SamuelNoesslboeck/SyArm_Mk1/README.md

[SyArm Mk1.pdf](https://github.com/SamuelNoesslboeck/SyArm_Mk1/files/11110466/SyArm.Mk1.pdf)
