SamuelNoesslboeck/SyArm_Mk1/documentation/articles/SyArm_Mechanics.pdf

# SyArm Mechanics

Samuel N¨osslb¨ock

April 2022

## 1 Introduction

This article is all about the mechanics of the SyArm. It is important to know which forces the load applies on which parts of the robot.

## 2 Servo replacement

As servo motors do not have enough torque to withstand the forces created by the load and the arms own weight, they have to be replaced by electronic cylinders. But as cylinders can only extend and descend they need to be build in between the joints, which requires additional vector mathematics to convert the angle previously needed for the servo motors into an extension for the cylinders.


The schematic above shows the second cylinder C2, which is responsible for the angle in joint A2. However the following equations can be applied to every cylinder when using the corresponding lengths instead of the ones used in this overall definition.
As many of the vectors are representing the construction their length is therefore known and can be used as constants:
| ⃗a1| = const | ⃗a2| = const | 1⃗a M| = const | 2⃗a M| = const | 1⃗a MC | = const | 1⃗a MC | = const | (1)

The control script now gets a position and calculates the angle α. When knowing this angle, the script can calculate the length of the cylinder C2 needed to match the angle.

h =

q
|⃗a1 − ⃗a1M|

2 + 1⃗a MC

2
g =

q
|⃗a2 − ⃗a2M|

2 + 2⃗a MC

2
(2)

β = α − arcsin
| 2⃗a MC |
g

− arcsin
| 1⃗a MC |
h
(3)

Applying the law of cosines, C2 can be calculated with

C2

2 = g
2 + h
2 − 2gh cos(β) | (4)

When knowing the minimum and maximum length of the cylinder Cmin and Cmax, the minimum and maximum angle of β can be calculated using

βmin/max = arccos

a

2 + b

2 − Cmin/max

2

2ab | !
(5)

1

5 CYLINDER FORCES | 2

## 3 Angular speed of cylinders

The cylinders used to replace the servo motors have a given extension speed vC which means their total cylinder length results in the integral of this constant.

C(t) = Z
vC dt = vC t + C0 | (6)

When using the formula for section two for the inner angle β and inserting the equation above for the dependency in cylinder length, the formula now gets a dependency of time.

β(C(t)) = arccos
a

2 + b

2 − C(t)

2
2ab |

−→ β(t) = arccos
a

2 + b

2 − v

2
C t

2 − 2vC tC0 − C

2
0
2ab |
(7)

Now that β has its dependency over time, the angular speed can be calculated using the derivative of the equation above.

ω(t) = dβ
dt =

2C(t)
p
−C(t)

4 − g

4 − h

4 + 2c

2 + g

2 + h

2 + 2g

2h

2

(8)

## 4 Optimizing angle span

As the SyArm should be able to reach as much space as easy as possible, the concept of the angle span is important.

βspan = βmax − βmin | (9)

## 5 Cylinder forces

To clarify the calculation of all forces and loads acting on the arm, each part is treated separately. However a few formulas can be generally defined, as they are true for all cylinder cases.
The following equations are all based on the fundamental principal of statics

XM⃗
n = 0 | XF⃗
n = 0 | (10)

The force acting on every cylinder balances the torque in the given arm section

F⃗Cn =

PM⃗ An−1|
|C⃗
n × ⃗an|
- C⃗
n | (11)

and the force acting on the joint in this section balances all acting forces

F ⃗An−1 = −

XF⃗
n | (12)

First Section


5 CYLINDER FORCES | 3
mL = const mG3 = const | ⃗a3| = const | (13)

F⃗L =

0
0
mLg
- F⃗G3 =

0
0
mG3g
- ⃗aC3 = ⃗a3M + ⃗a3MC | (14)

F⃗C3 =

|F⃗L × ⃗a3 + F⃗G3 × ⃗aG3|
|C⃗
3 × ⃗aC3|
- C⃗
3 | F⃗A2 = −(F⃗L + +⃗ FG3 − F⃗C3) | (15)

Second Section


mL = const mG3 = const | ⃗a3| = const | (16)
