SamuelNoesslboeck/SyArm_Mk1/documentation/articles/Stepper_Motor.pdf

# Stepper Motors: Acceleration and torque curves

Samuel N¨osslb¨ock

October 2022

## 1 Introduction

This article is all about the optimization for stepper motors, the perfect way to start/stop them, and the maximum loads at certain speeds.

## 2 Motor torque and ”Coil pendulum”

Taking a stepper motor with two different coils A and B with the charging curve being defined as

ic(t) = Im(1 − e

t
τ ) τ =

ImL
U

(1)

IM being the maximum current flowing though the coil, L being the inductivity and U being the volage applied to the coil. Considering the torque has a linear proportionality to the current flowing though the coil:

T(t) ↔ i(t)

the following equations are valid for current and torque.
As the coils get charged and discharged, a kind of pendulum forms with a peak saturation voltage isat(t)

isat(t) = (isat(t) + Im)(1 − e

− t
τ ) − isat(t)

isat(t)(1 + e

− t
τ ) = Im(1 − e

− t
τ )

isat(t) = Im

1 − e

− t
τ
1 + e

− t
τ

⇒ T(t) = TS

1 − e

− t
τ
1 + e

− t
τ

(2)

Which, when used for calculating the torque, results in

limω→0

T(ω) = TS

1 − e

− t
τ
1 + e

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
The limit makes the function defined for an ω of 0, as is approches TS. TS represents the motors stall torque, ω the current rotational speed in radiants, nM the number of charging turns per turn (e.g. 200 step motor with 2 coils has 100 rechargings per turn) IM represents the maximum current for the coils, L the inductivity of the coils and U the voltage applied on the coils.

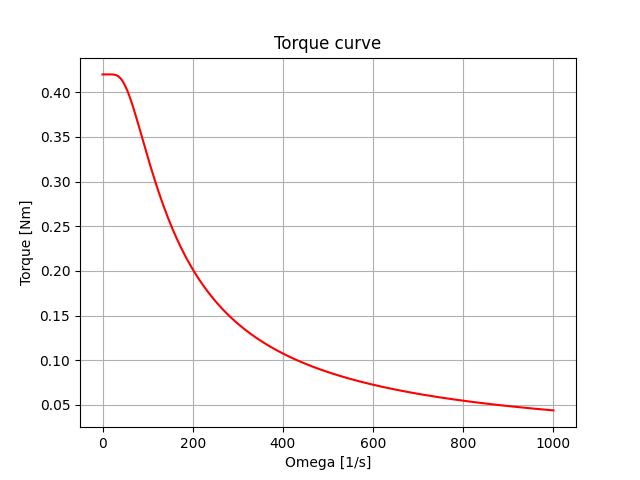
[picture p21: figure]

1

4 ACCELERATION CURVE | 2

## 3 Start and Stop speed

The starting point of an acceleration curve is the first step starting from standstill. If the motor cannot reach the first step before the controller recharges the coils, the motor will end up not working at all. As mentioned, the acceleration of the motor is the main parameter if it comes to start/stop speed. It is defined as following

α(t) = αm(1 − e

− t
τ ) αm =

TS − TL
J
TL < TS | (4)

With J being the inertia moment of the whole construction connected to the motor, TL being the torque loss and αM the maximum angluar velocity. Using the basic relationships over the integral

ω(t) = Z

α(t) dt ϕ(t) = Z
ω(t) dt

ϕ(t) = αm(

t

2
2

− τ

2
e

− t
τ ) | (5)
Especially for small motors at high voltages, the second term in the brackets can be ignored, as τ | 2 approaches 0.
Now to get the minimum first step time, this distance has to equal the step distance of the motor

2π
nS

= αm

t

2
2

t =

r
4π
αmnS
| (6)

where nS is the step count of the motor.

## 4 Acceleration curve

When knowing the start/stop speed, the acceleration curve can be defined as a series:

t0 =

r
4π
αmnS

tn =

2π
nSω(tt)

tt =

nX⁻¹

i=0

ti | (7)

Example curve:

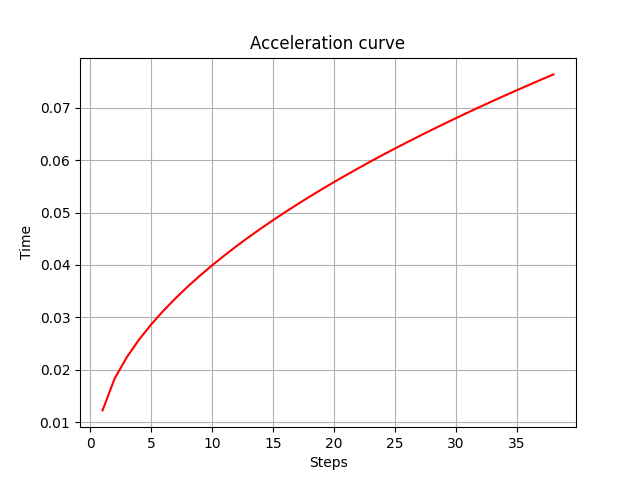
[picture p22: figure]
