SamuelNoesslboeck/SyArm_Mk1/documentation/articles/SyArm_Positioning.pdf

# SyArm Positioning

Samuel N¨osslb¨ock

April 2022

## 1 Introduction

The SyArm is build up from two arms and a tong, represented by three vectors.

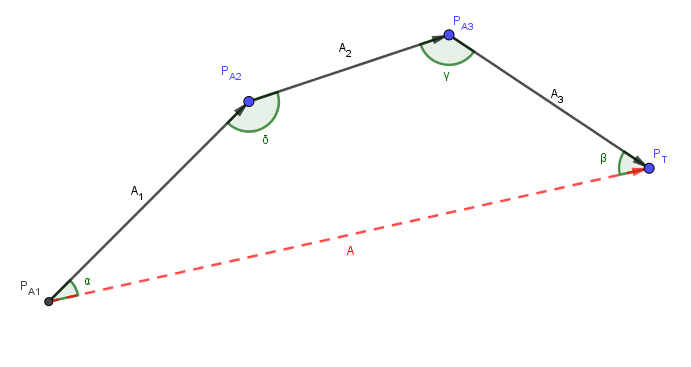
[picture p23: figure]

The robot is controlled by a Raspberry PI 3 with a simple systemd service which keeps the main python script alive.
The main positioning function just receives the three dimensional vector A⃗ and has to calculate all for the positioning relevant servo angles.
So the control script knows:
- All lengths A, A ⃗
10, A20, A30
- Another property δ = γ
An should calculate
- The servo angles ϕB, ϕA1, ϕA2, ϕT1
- The arm vectors A⃗

1, A⃗

2, A⃗
3

## 2 Base Angle ϕB

As the unmodified vectors all point along the Y-Axis, the base angle is the only angle that can move all arms towards the target and “create” a X-coordinate.

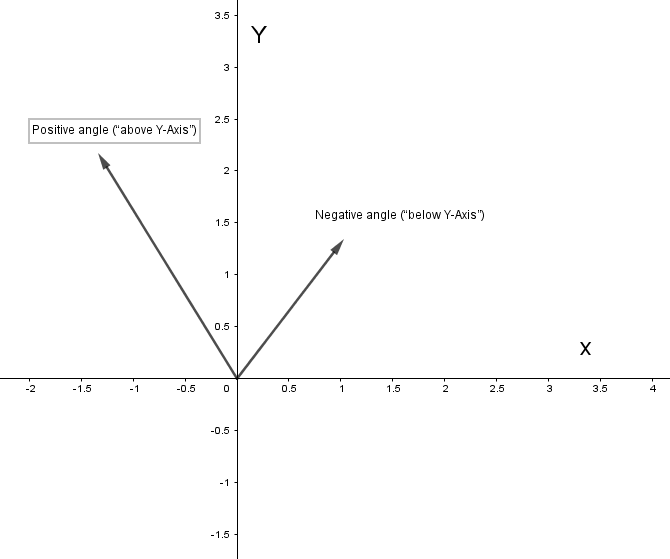
[picture p24: figure]

Because of this default Y-Axis, the system for a “positive” base angle is rotated by 90 degrees. Which means arcsin(y) cannot be applied here, the fully defined arc-function for this case is

ϕB(A⃗) =
arcsin(−xˆ) | if y >ˆ | 0
π + arcsin(−xˆ) otherwise | xˆ =

A⃗
q x
A⃗2
x + A⃗2
y

, yˆ =

A⃗
q y
A⃗2
x + A⃗2
y

(1)

## 3 Arm angles

To simplify the following equations simpler labels have been assigned to the following labels:
a = A, | b ⃗ | = A⃗
3, | c = A⃗
2, | d = A⃗
1
As we have all lengths of our polygon, we can extend the lengths b and d, to create a triangle.

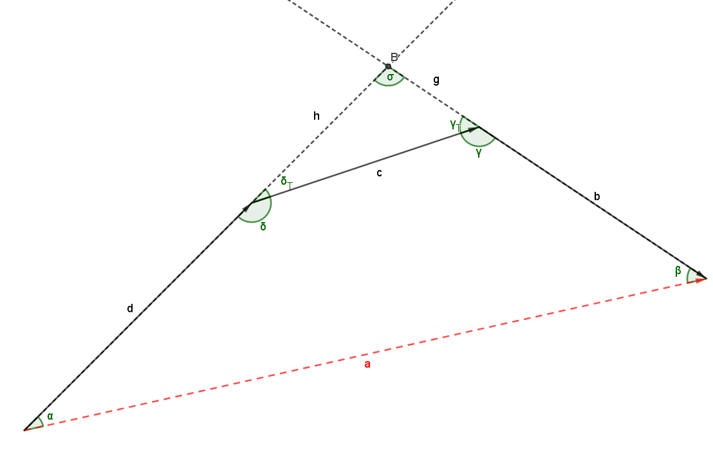
[picture p25: figure]

Considering the property δ = γ the following equations form

360 = α + β + γ + δx | (2)
180 = α + β + σ = δT + γT + σ | (3)
180 = δ + δT = γ + γT | (4)
δT = γT | g = h | (5)

As there are now two triangles, one of them being an isosceles one, the law of cosines can be applied

c

2 = h

2 + g

2 − 2gh cos(σ) = 2g

2
(1 − cos(σ)) | (6)

a

2 = (d + g)

2 + (b + g)

2 − 2(d + g)(b + g) cos(σ) | (7)

Out of equation (6), the cosine of sigma can be calculated with

cos(σ) = 1 −

| c
| 2
| 2g
| 2

(8)

When this result is inserted into equation (7) we can solve the unknown length g

a

2 = (d + g)

2 + (b + g)

2 − 2(d + g)(b + g)(1 −

c

2
2g

2 )
0 = d

2 + 2dg + g

2 + b

2 + 2bg + g

2 − 2db + | dbc² g
2 | − 2dg +

dc²
g − 2gb +

bc²
g − 2g

2 + c

2
0 = (−a

2 + b

2 + c

2 + d

2 − 2db) + 1
| g (dc² + bc²

) + 1
g

2 (dbc²
)
0 = g

2
(−a

2 + b

2 + c

2 + d

2 − 2db) + g(dc² + bc²

) + dbc²

(9)

For calculation, some helper variables are introduced

aC = −a

2 + b

2 + c

2 + d

2 − 2db
bC = dc² + bc²
cC = dbc²

(10)

g1,2 = −

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
(11)

When having the first result for g [g1], equation (8) can be used to calculate σ, γ and δ

σ = arccos(1 −

c

2
2g

2 )
γT =

180−σ
2
γ = δ = 180 − γT

(12)

When now having σ and the length of g, the law of sines can be applied

a
sin(σ)

=

d + h
sin(β)

=

b + g
sin(α)

(13)

So α and β result in
α = arcsin(sin(σ)(b + g)
a
) | (14)

β = arcsin(sin(σ)(d + h)
a
) | (15)

## 4 Arm vectors

The points of each joint and the final position vector can be calculated by using the default vectors

A⃗

10 = A⃗
1(ϕB = 0, ϕA1 = 0) =

0

A10
0
| (16)

A⃗

20 = A⃗
2(ϕB = 0, ϕA1 = 0, ϕA2 = 0) =

0

A20
0
- (17)

A⃗

30 = A⃗
3(ϕB = 0, ϕA1 = 0, ϕA2 = 0, ϕA3 = 0) =

0

A30
0
- (18)

and rotating around the servo axis using rotation matrices. The base rotation is represented by a Z-axis rotation, the joints by a X-axis rotation

A⃗

1(ϕB, ϕA1) = RZ(ϕB) · RX(ϕA1) · A⃗
10; PA1 =

0
0
0
- PA2(ϕB, ϕA1) = PA1 + A⃗
1(ϕB, ϕA1) | (19)

A⃗

2(ϕB, ϕA1, ϕA2) = RZ(ϕB) · RX(ϕA1) · RX(ϕA2) · A⃗

20 | PA3(ϕB, ϕA1, ϕA2) = PA2 + A⃗
2(ϕB, ϕA1, ϕA2) | (20)

A⃗

3(ϕB, ϕA1, ϕA2, ϕA3) = RZ(ϕB) · RX(ϕA1) · RX(ϕA2) · RX(ϕA3) · A⃗
30
PT1(ϕB, ϕA1, ϕA2, ϕA3) = PA3 + A⃗
3(ϕB, ϕA1, ϕA2, ϕA3)

(21)

Taking all of these vectors, the position vector A⃗ can be calculated

A⃗(ϕB, ϕA1, ϕA2, ϕA3) = A⃗

1(ϕB, ϕA1) + A⃗

2(ϕB, ϕA1, ϕA2) + A⃗
3(ϕB, ϕA1, ϕA2, ϕA3)
A⃗(ϕB, ϕA1, ϕA2, ϕA3) = RZ(ϕB) · RX(ϕA1) ·
A⃗
10 + RX(ϕA2) ·
A⃗

20 + RX(ϕA3) · A⃗

30 | (22)

## 5 Coordinate systems and conversions

The control script uses multiple coordinate systems listed here

Kath =

x
y
z
- Rot =

r
ϕZ
ϕX
- (23)

Kath and Rot both have their advantages and disadvantages, Rot is easier to use for the control system (it always converts to this system), while Kath is easier for human use. The conversion functions are the following

Kath(Rot) = RZ(ϕZ) · RX(ϕX) ·

0
r
0
- (24)

Rot(Kath) =

|Kath|
arctanF (y, −x)
arctanF (

p
x

2 + y

2, z)

- arctanF (x, y) =

arctan(y/x) | if x > 0
π + arctan(y/x) | if x < 0

π
2

if y > 0
−π
2

if y < 0
0 otherwise

otherwise

(25)
