SamuelNoesslboeck/SyArm_Mk1/documentation/images/actual/README.md

# Images of the actual robot

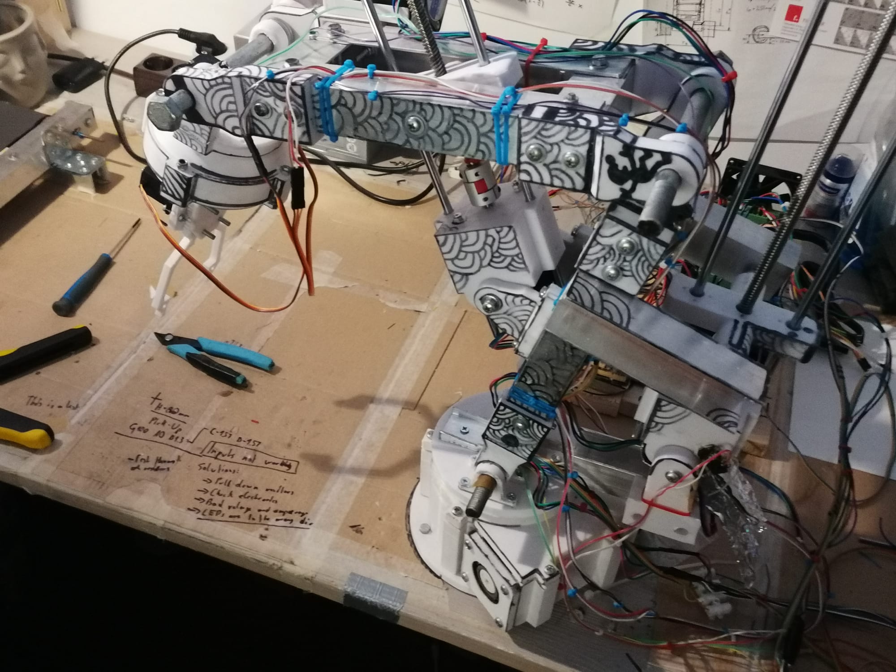
[picture p26: documentation/images/actual/Main_view.jpg]

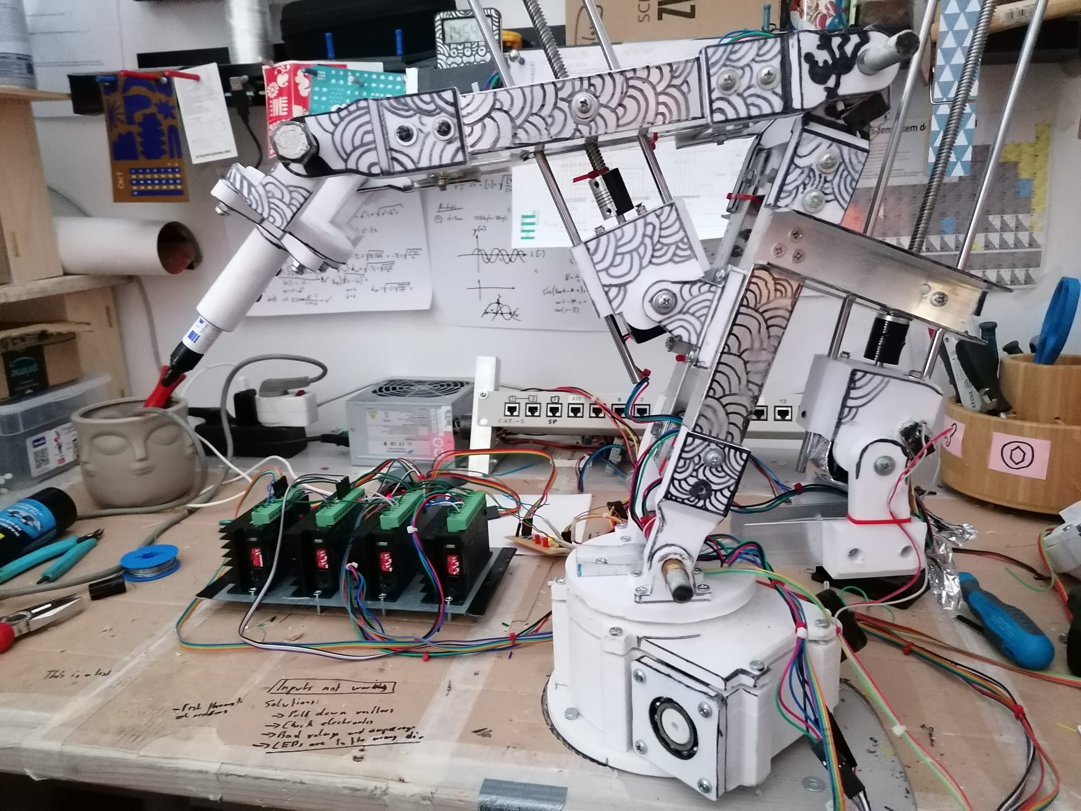
[picture p27: documentation/images/actual/Different_tools.jpg]

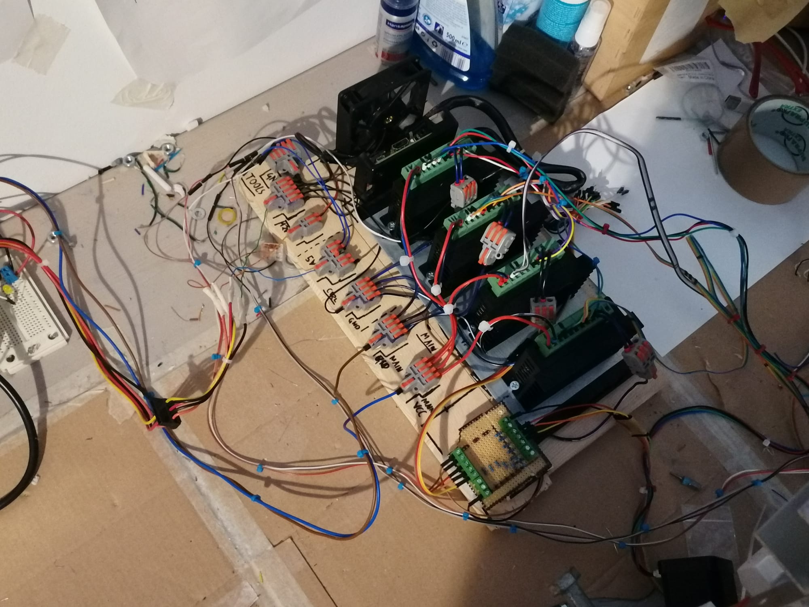
[picture p28: documentation/images/actual/Electronics.jpg]
