SamuelNoesslboeck/SyArm_Mk1/sketches/ArticleRaw.pdf

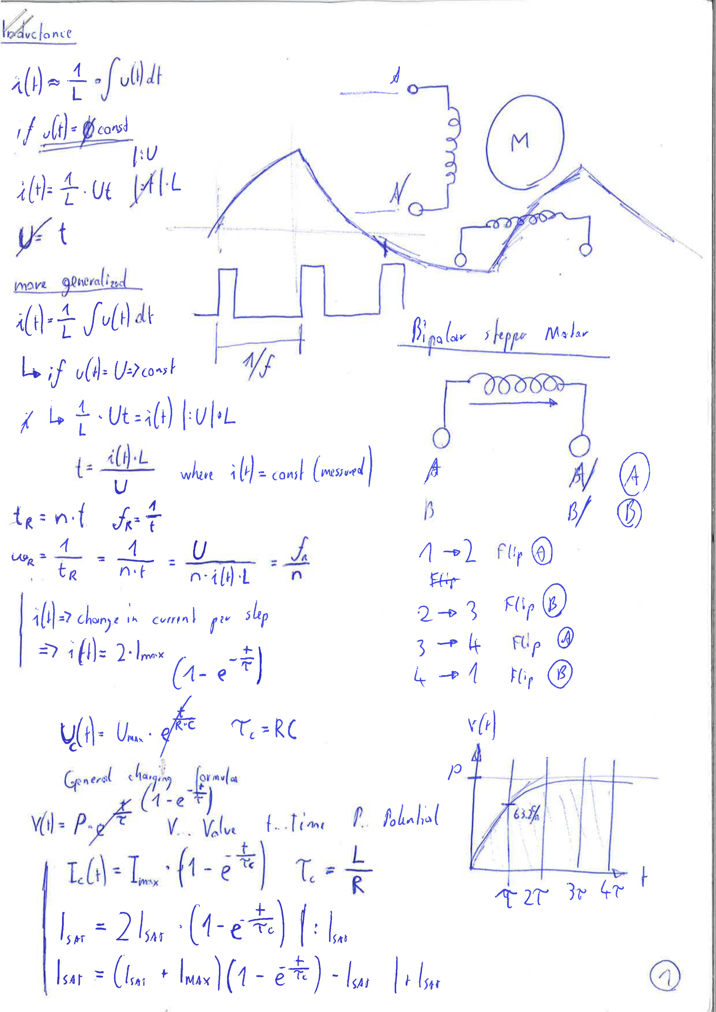
[picture p29: page 1]
