SamuelNoesslboeck/SyArm_Mk1/sketches/TimeFields.pdf

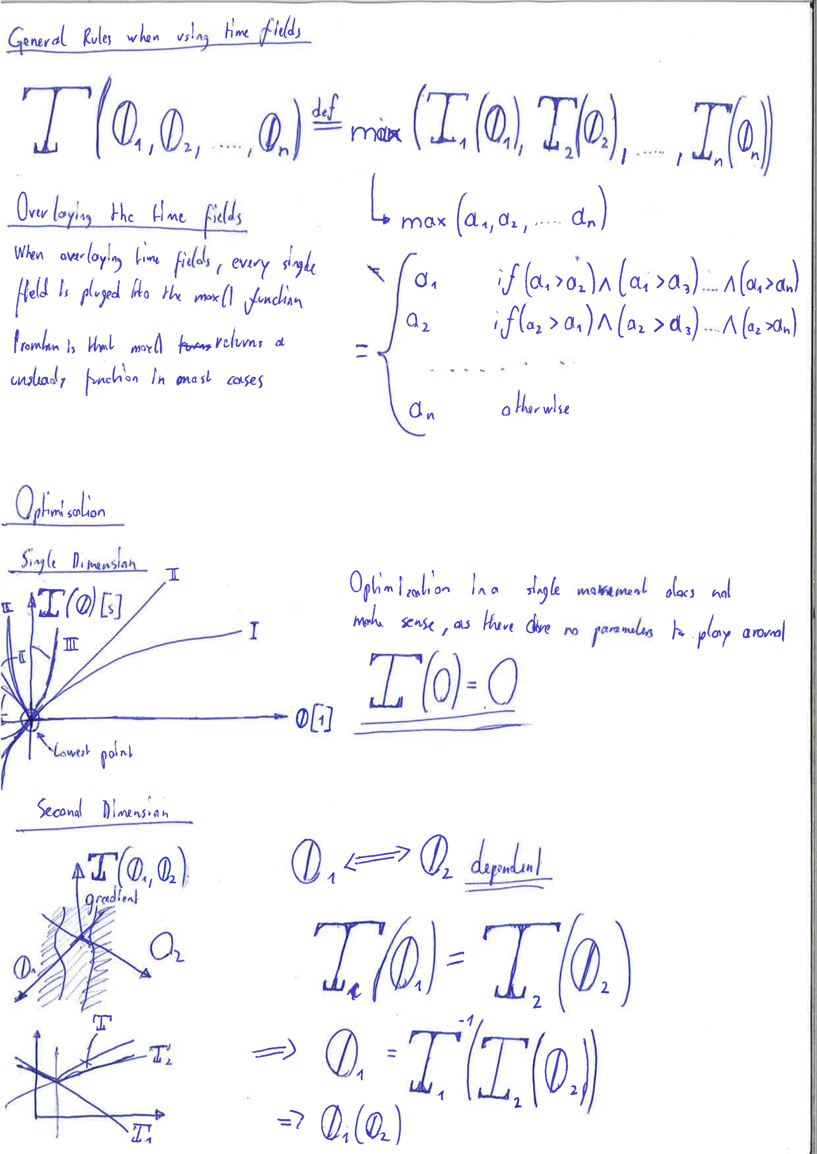
[picture p30: page 1]
