SamuelNoesslboeck/SyArm_Mk1/sketches/TimeFields_2.pdf

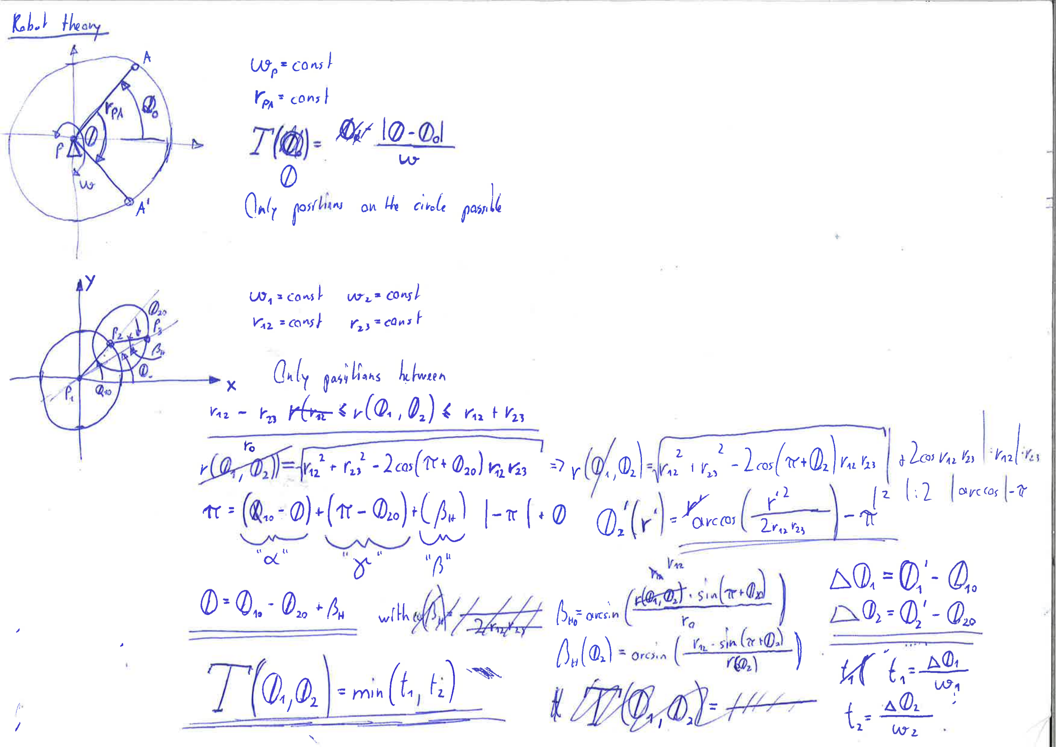
[picture p31: page 1]
