SamuelNoesslboeck/SyArm_Mk1/documentation/images/Base.png

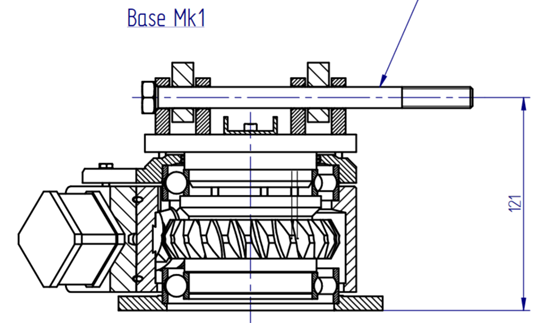
documentation/images/Base.png
