SamuelNoesslboeck/SyArm_Mk1/documentation/images/Cylinder.png

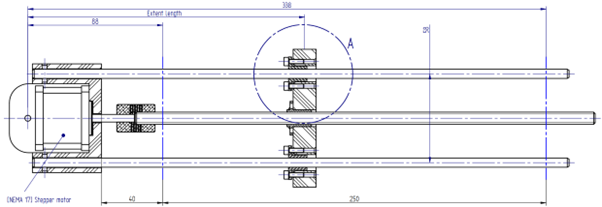
documentation/images/Cylinder.png
