SamuelNoesslboeck/SyArm_Mk1/documentation/images/CylinderTriangle.png

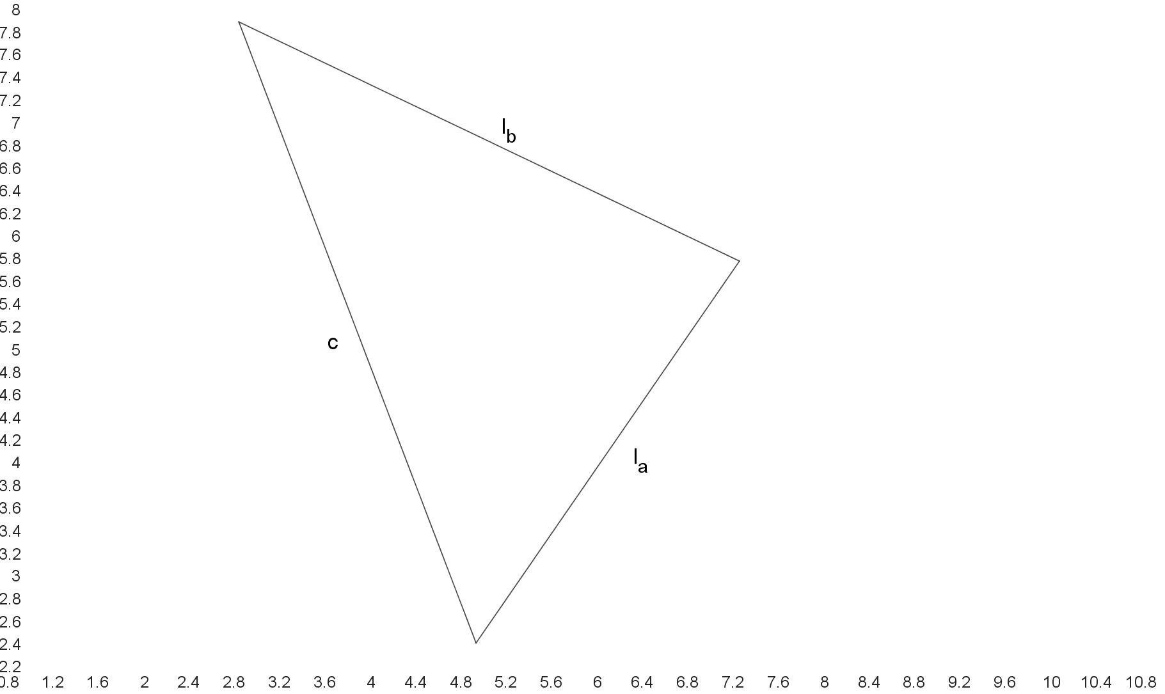
documentation/images/CylinderTriangle.png
