SamuelNoesslboeck/SyArm_Mk1/SyArm Mk1_files/image001.png

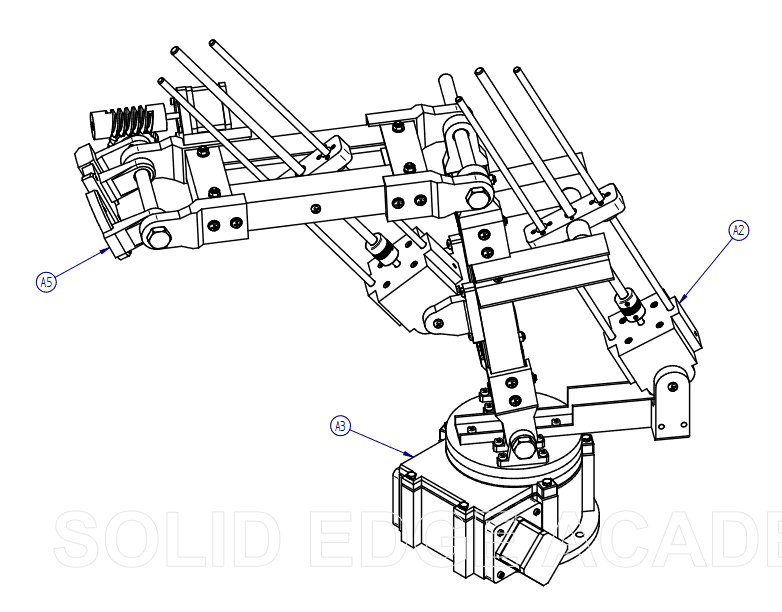
SyArm Mk1_files/image001.png
