SamuelNoesslboeck/SyArm_Mk1/SyArm Mk1_files/image007.png

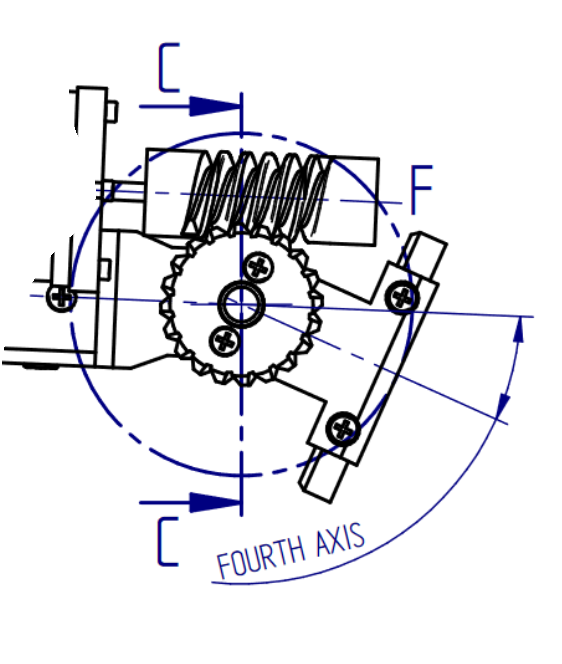
SyArm Mk1_files/image007.png
