SamuelNoesslboeck/SyArm_Mk1/SyArm Mk1_files/image019.png

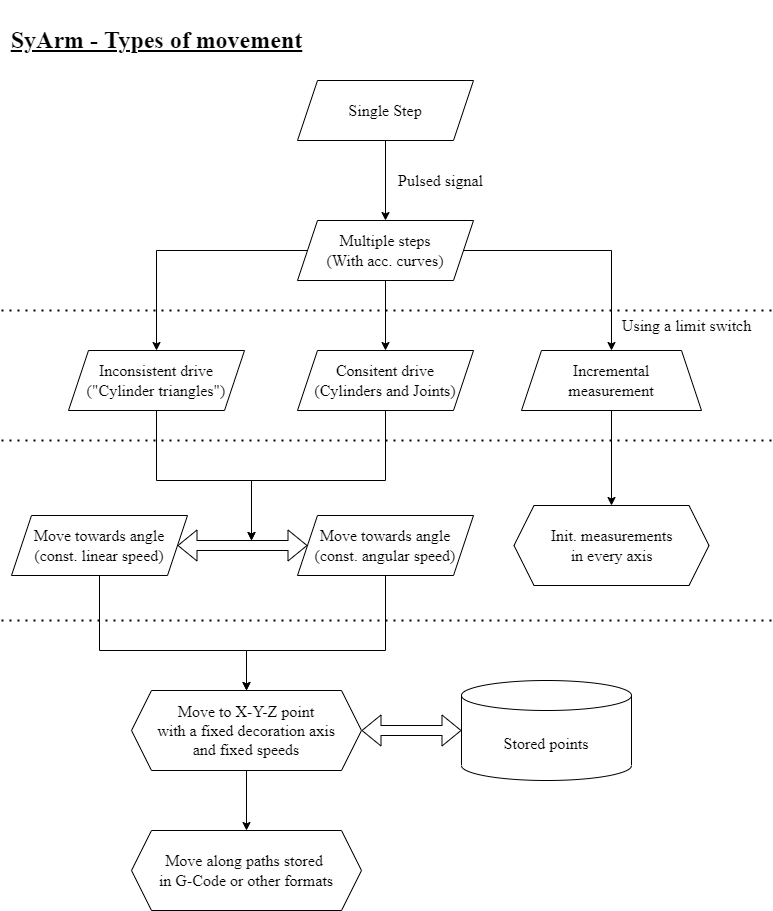
SyArm Mk1_files/image019.png
