SamuelNoesslboeck/SyArm_Mk1/construction/A4_Arm_Mk2/README.md

# Arm

Version: Mk2.4.0

## Construction

 - S1: First Segment 
 - S2: Second Segment
