SamuelNoesslboeck/SyArm_Mk1/construction/A1_SimpleFrame_Mk1/Drafts/SimpleFrame_Mk1.pdf

A

A

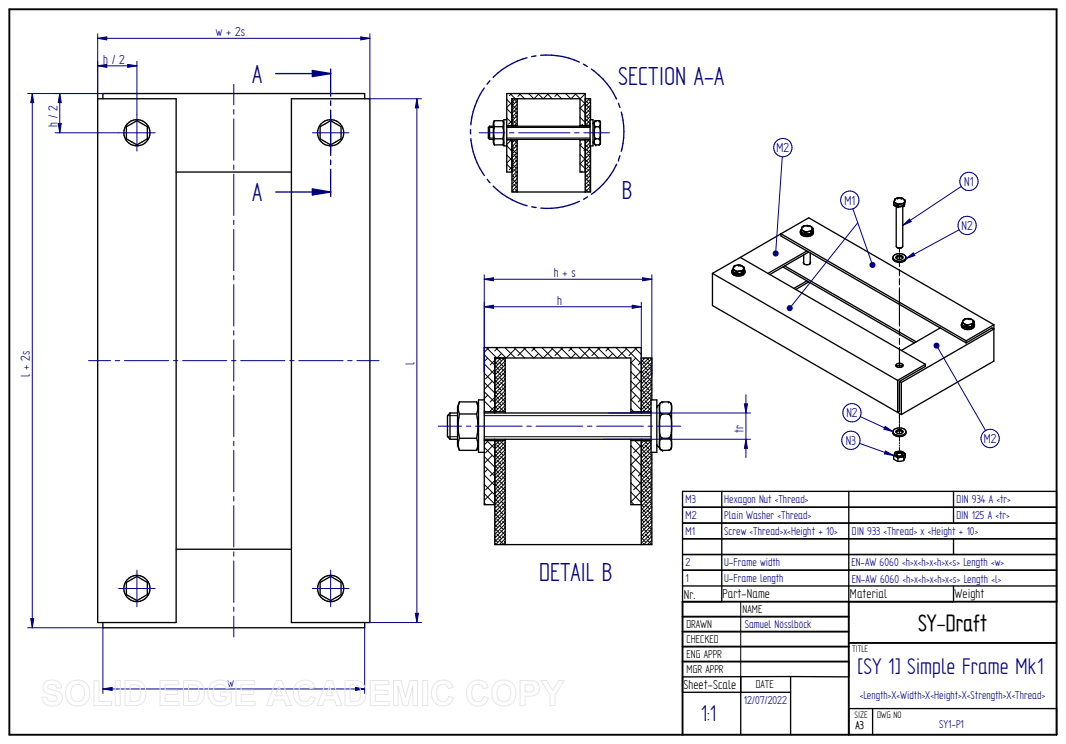
[picture p38: page 1]
SECTION A-A; DETAIL B

M3 | Hexagon Nut <Thread> | | DIN 934 A <tr>
M2 | Plain Washer <Thread> | | DIN 125 A <tr>
M1 | Screw <Thread>x<Height + 10> | DIN 933 <Thread> x <Height + 10>

2 | U-Frame width | EN-AW 6060 <h>x<h>x<h>x<s> Length <w>
1 | U-Frame length | EN-AW 6060 <h>x<h>x<h>x<s> Length <l>
Nr. | Part-Name | Material | Weight

NAME | SY-Draft

DRAWN | Samuel Nösslböck
CHECKED
ENG APPR
MGR APPR
Sheet-Scale | DATE
1:1 | 12/07/2022

TITLE
[SY 1] Simple Frame Mk1

<Length>X<Width>X<Height>X<Strength>X<Thread>

SIZE A3 | DWG NO SY1-P1
