SamuelNoesslboeck/SyArm_Mk1/construction/A2_Cylinder_Mk2/Drafts/A2_Cylinder_Mk2_2.pdf

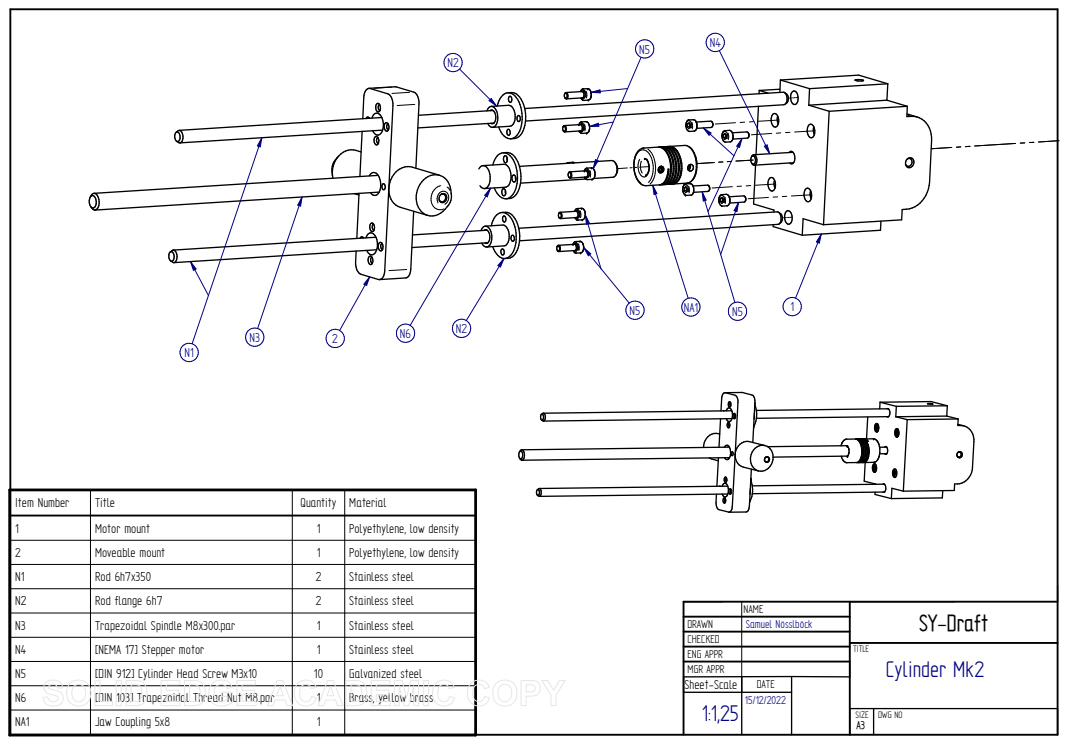
[picture p39: page 1]
MGR APPR; TITLE; Cylinder Mk2; SIZE A3; DWG NO; [DIN 912] Cylinder Head Screw M3x10; Galvanized steel; [DIN 103] Trapezoidal Thread Nut M8.par; Brass, yellow brass; Jaw Coupling 5x8

Item Number | Title | Quantity | Material
1 | Motor mount | 1 | Polyethylene, low density
2 | Moveable mount | 1 | Polyethylene, low density
N1 | Rod 6h7x350 | 2 | Stainless steel
N2 | Rod flange 6h7 | 2 | Stainless steel
N3 | Trapezoidal Spindle M8x300.par | 1 | Stainless steel
N4 | [NEMA 17] Stepper motor | 1 | Stainless steel

NAME | SY-Draft

DRAWN | Samuel Nösslböck
CHECKED
ENG APPR

Sheet-Scale | DATE
1:1,25 | 15/12/2022
