SamuelNoesslboeck/SyArm_Mk1/documentation/drafts/A_SyArm_Mk1.pdf

B

B

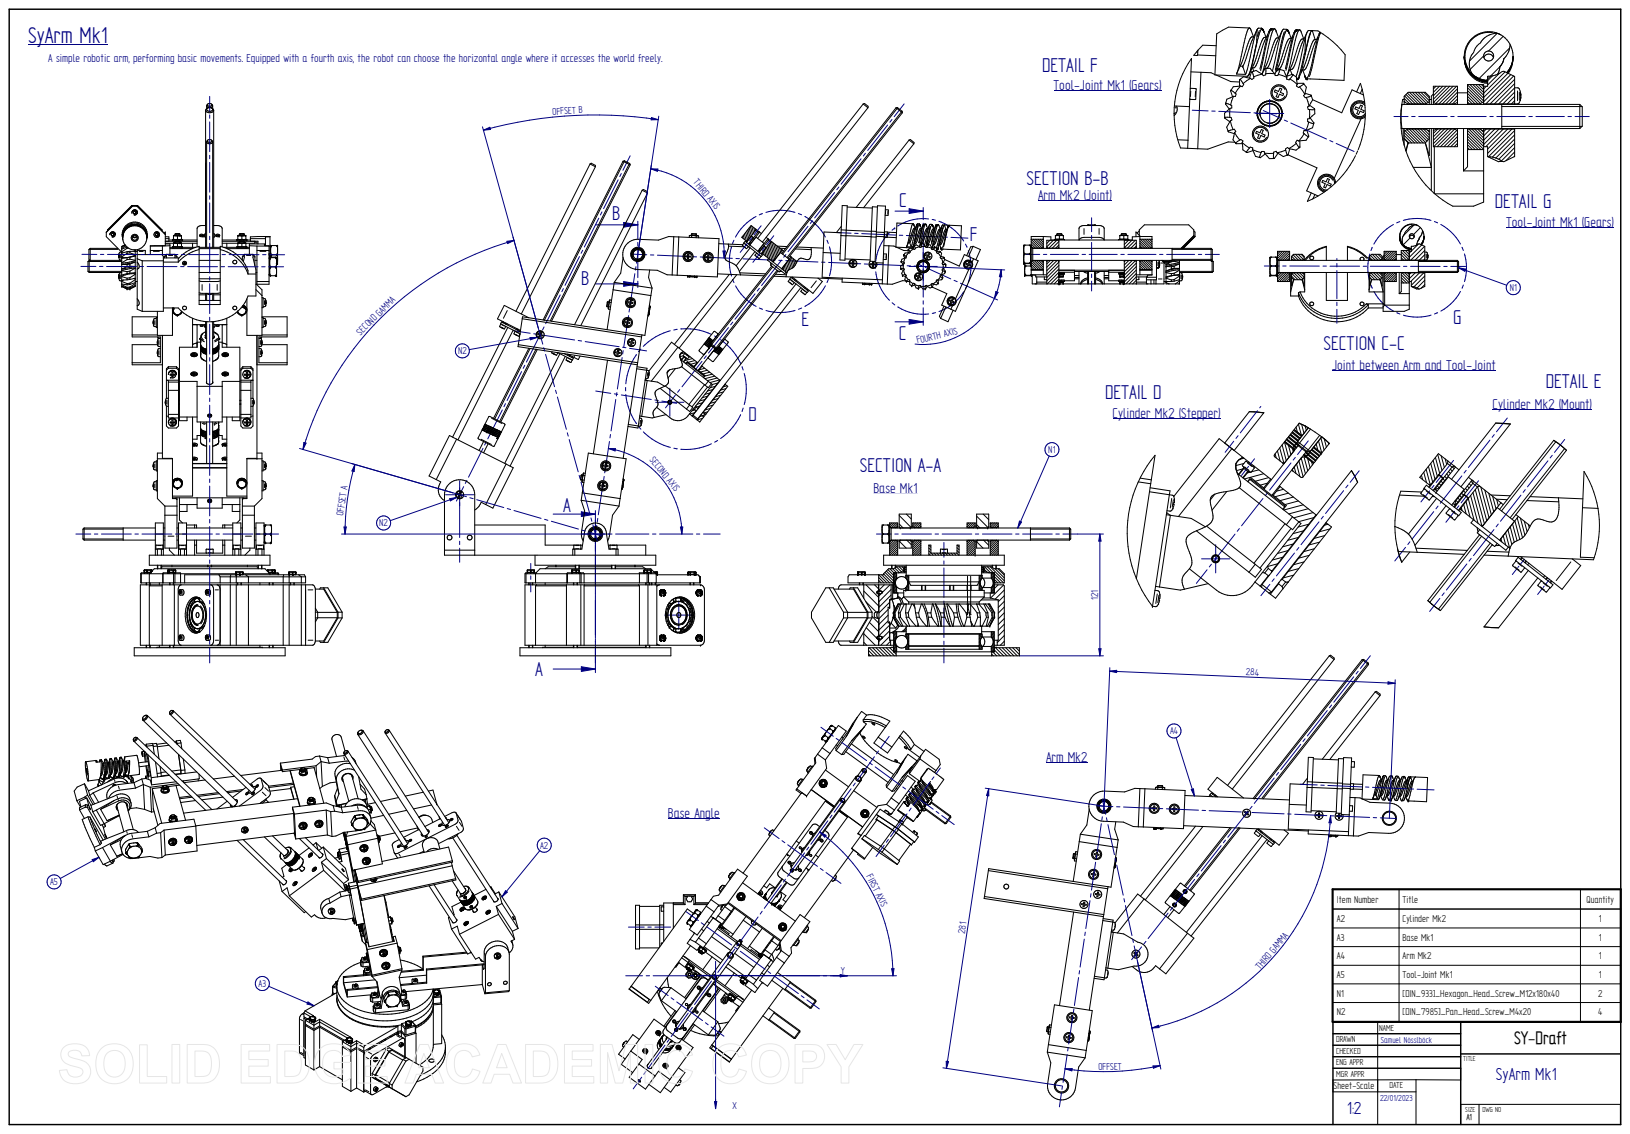
[picture p40: page 1]
TITLE; SyArm Mk1; DETAIL D; DETAIL E; SECOND AXIS; FIRST AXIS; THIRD AXIS; FOURTH AXIS; SECTION A-A; SECTION B-B; OFFSET; SECOND GAMMA; OFFSET B; THIRD GAMMA; Base Mk1; Arm Mk2; Base Angle; Item Number; Title; Quantity; Cylinder Mk2; Tool-Joint Mk1; [DIN_933]_Hexagon_Head_Screw_M12x180x40; [DIN_7985]_Pan_Head_Screw_M4x20; Arm Mk2 (Joint); Cylinder Mk2 (Stepper); Cylinder Mk2 (Mount)

A simple robotic arm, performing basic movements. Equipped with a fourth axis, the robot can choose the horizontal angle where it accesses the world freely.

DETAIL F
Tool-Joint Mk1 (Gears)

DETAIL G

SECTION C-C
Joint between Arm and Tool-Joint

NAME | SY-Draft

DRAWN | Samuel Nösslböck
CHECKED
ENG APPR
MGR APPR
Sheet-Scale | DATE
1:2 | 22/01/2023

SIZE A1 | DWG NO
