SamuelNoesslboeck/SyArm_Mk1/documentation/drafts/A2_Cylinder_Mk2.pdf

A

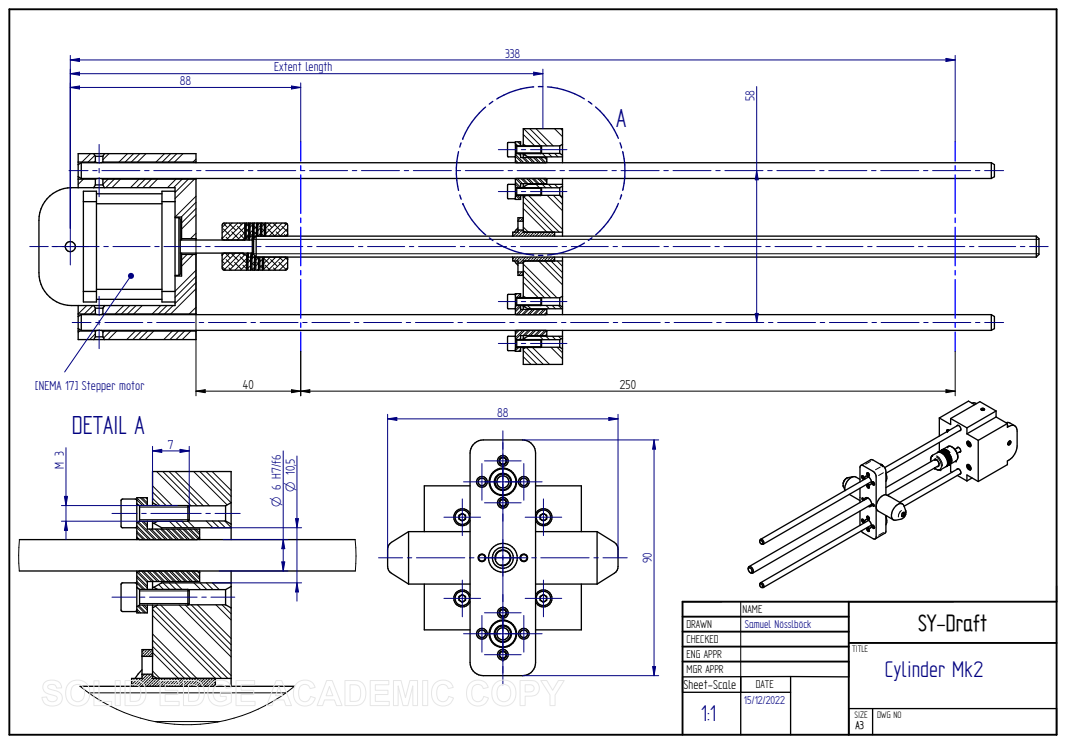
[picture p41: page 1]
TITLE; Cylinder Mk2; Extent length

[NEMA 17] Stepper motor
DETAIL A

NAME | SY-Draft

DRAWN | Samuel Nösslböck
CHECKED
ENG APPR
MGR APPR
Sheet-Scale | DATE
1:1 | 15/12/2022

SIZE A3 | DWG NO
