SamuelNoesslboeck/SyArm_Mk1/documentation/pdf/TypesOfMovements.pdf

## SyArm - Types of movement

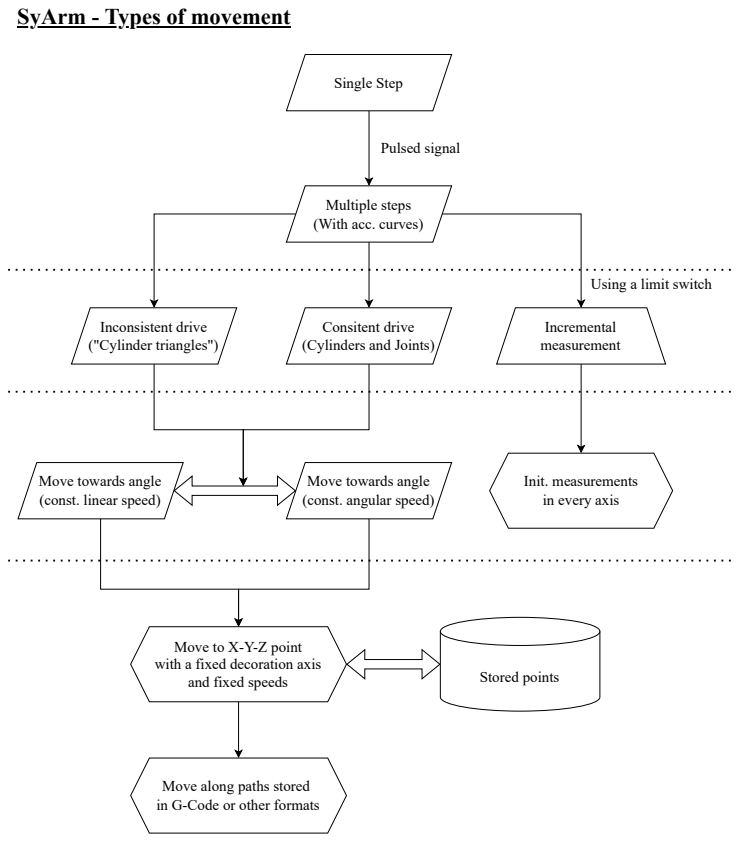
[picture p42: page 1]
Single Step; Pulsed signal; Inconsistent drive ("Cylinder triangles"); Incremental measurement; and fixed speeds; Stored points

Multiple steps
(With acc. curves)

Using a limit switch

Consitent drive
(Cylinders and Joints)

Move towards angle
(const. linear speed)

(const. angular speed)

Init. measurements
in every axis

Move to X-Y-Z point
with a fixed decoration axis

Move along paths stored
in G-Code or other formats
