SamuelNoesslboeck/SyArm_Mk1/documentation/drafts/A4_S1_S2_FirstSegment_SecondSegment.pdf

A | A
C | C

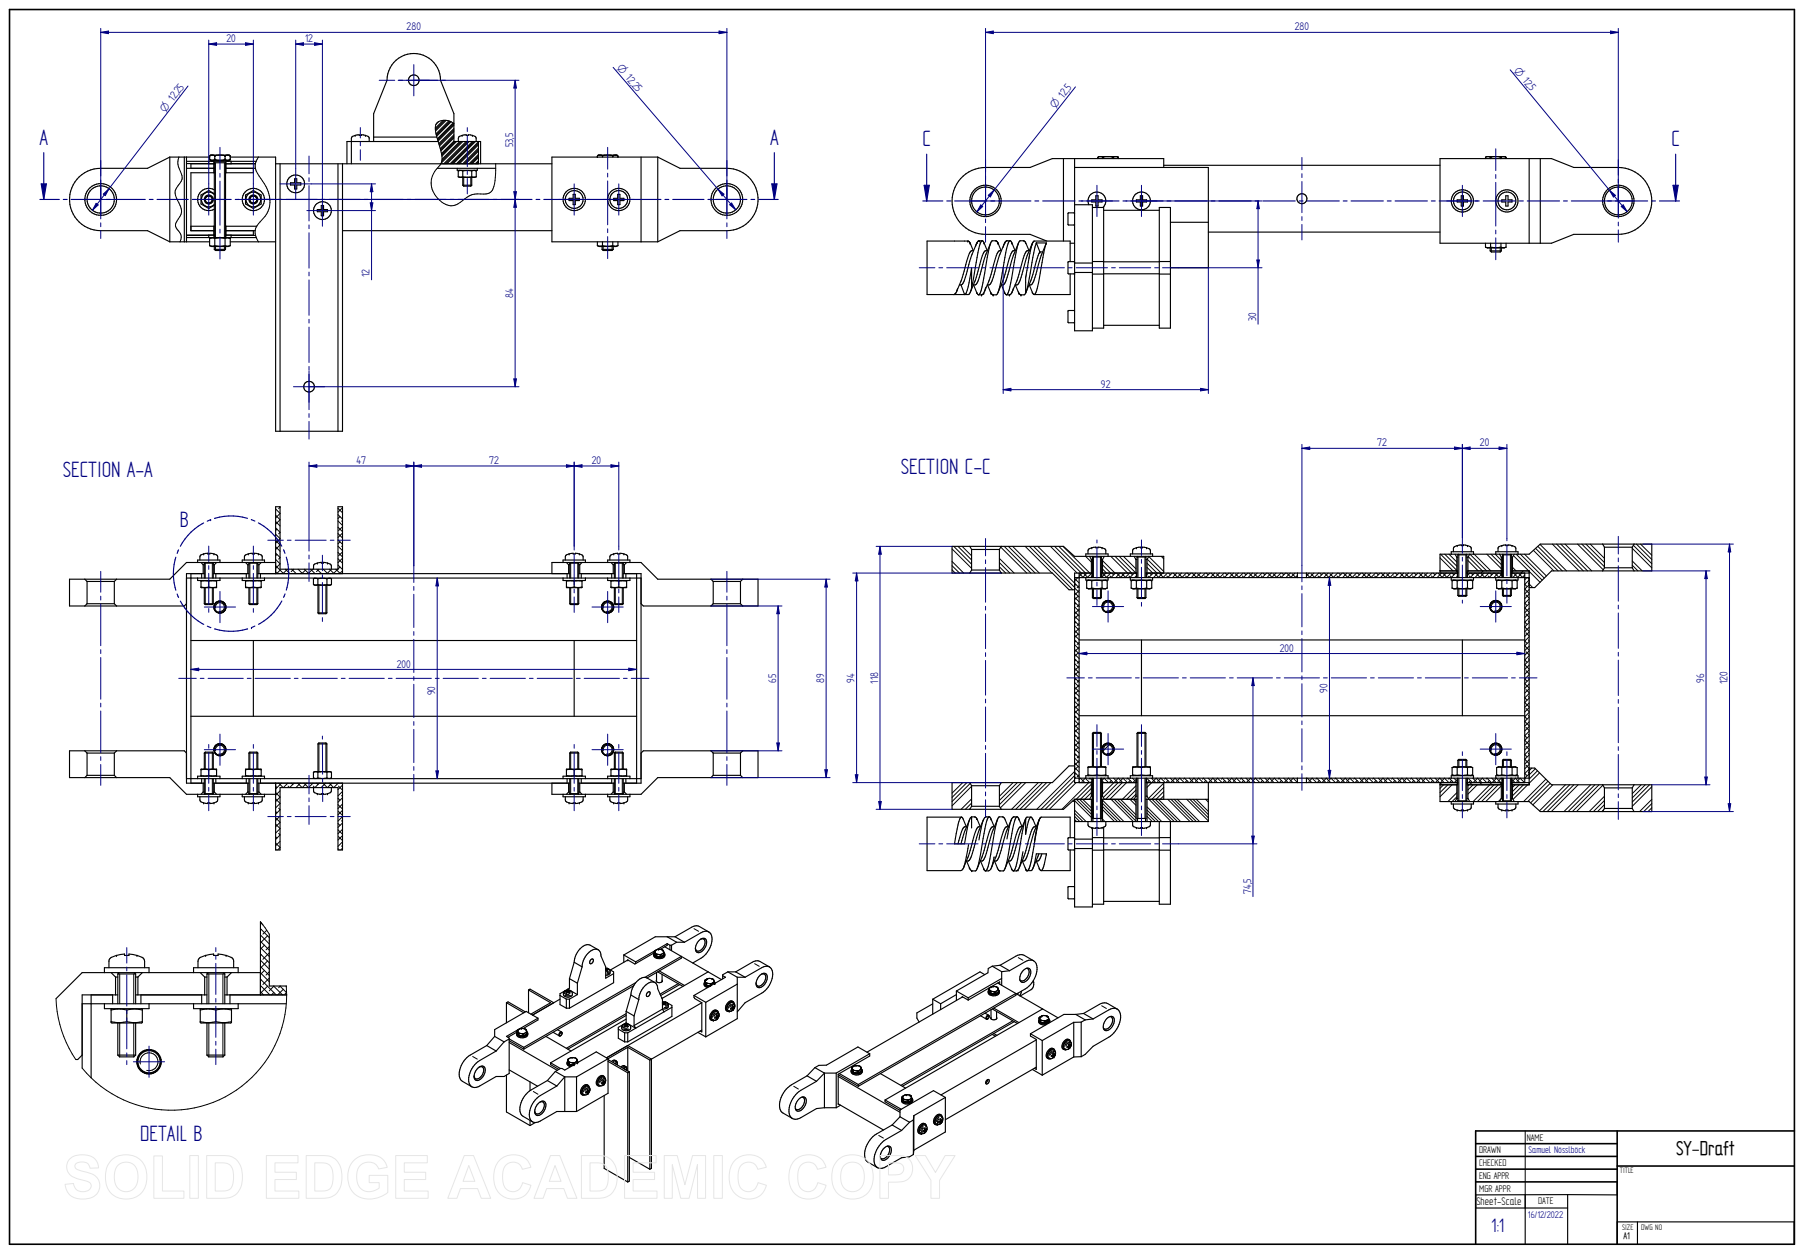
[picture p43: page 1]
TITLE; SECTION A-A; DETAIL B; SECTION C-C

NAME | SY-Draft

DRAWN | Samuel Nösslböck
CHECKED
ENG APPR
MGR APPR
Sheet-Scale | DATE
1:1 | 16/12/2022

SIZE A1 | DWG NO
