SamuelNoesslboeck/SyArm_Mk1/(commit log)

2022-10-03 Upload files #1
    [Arm_Mk2.cfg, FirstSegment.cfg, SecondSegment.cfg]
2022-11-17 Restructuring #2
    [A.cfg, Arm_Mk1.cfg, Arm_Mk2.cfg, AxisBearing_Mk1.cfg, Base_Mk1.cfg, Bearing.cfg, CylinderBase.cfg, FirstSegment.cfg]
2022-11-19 Added protocol
    [Protocol.xlsx]
2022-11-24 Edited docs
    [A_Cylinder_Mk2.cfg, Arm_Mk1.cfg, Arm_Mk2.cfg, Base_Mk1.cfg, Bearing.cfg, CylinderBase.cfg, FirstSegment.cfg, Protocol.xlsx]
2022-12-05 Version 1.1.0
    [A.cfg, A3_Base_Mk1.cfg, A4_Arm_Mk2.cfg, A4_S1_FirstSegment.cfg, A4_S2_SecondSegment.cfg, A5_AxisBearing_Mk1.cfg, A_Cylinder_Mk2.cfg, A_SyArm_Mk1.cfg]
2022-12-15 New Cylinder Drawing
    [A_Cylinder_Mk2.cfg, Jaw Coupling 5-Tr8.cfg, Jaw_Coupling_5xTr8.cfg]
2022-12-16 Fixed Asm #1
    [A4_Arm_Mk2.cfg, A_SyArm_Mk1.cfg]
2022-12-18 Improved Segments
    [A_SyArm_Mk1.cfg, Base_Mk1.cfg]
2022-12-19 New structure
    [A3_Base_Mk1.cfg, A5_AxisBearing_Mk1.cfg, A5_ToolJoint_Mk1.cfg, A6_AxisBearing_Mk1.cfg, A_SyArm_Mk1.cfg, AxisBearing_Mk1.cfg, Bearing.cfg, Testing.cfg]
2023-01-16 Base Version Mk1.1.0
    [A3_Base_Mk1.cfg, A_SyArm_Mk1.cfg, N3_[DIN_625]_16004.cfg]
2023-01-22 Main assembly file
    [A_SyArm_Mk1.cfg]
2023-02-07 Finished first draft version
    [A_SyArm_Mk1.cfg]
2023-03-30 fixed construction
    [SimpleFrame_Mk1.cfg, [SY 1] SimpleFrame_Mk1 200x90x30.cfg, [SY_1]_SimpleFrame_Mk1_200x90x30.cfg]
